bradrblack/device-monitor/hw/case/README.md

# Device Monitor cases

There are two printed cases. Both are a tray and a lid that click together with no
screws, and both clamp the accelerometer firmly so it feels the machine's vibration.

| | Slide-in case (recommended) | PCB case |
|---|---|---|
| Source | `slide_in_case.scad` | `device_monitor_case.scad` |
| Print | `slide_tray.stl`, `slide_lid.stl` | `tray.stl`, `lid.stl` |
| Outside | 46.2 x 27.6 x 15 mm | 55.8 x 31 x 23 mm |
| Electronics | SuperMini + GY-346, 4 wires soldered direct | SuperMini + GY-346 + bulk cap on the [carrier PCB](../PCB.md) |
| Parts held by | wall grooves, lid posts, floor rails and pins | printed pins through the PCB's holes, lid posts |
| RESET | flex tab in the lid | guide tube for a paperclip |
| Antenna | lid ceiling, in a recess | inside the lid's side skirt |
| Status LED | row of holes along the RESET side | through the vent holes |
| Zip-tie slot | 4.8 mm | 5.5 mm |

The slide-in case is smaller and needs no PCB order, only four short wires. Use the
PCB case if you already have carrier boards or want the bulk capacitor.

`check_case.sh [file.scad]` renders the clash checks for either case (lid against
tray, and each against the parts); every line must say ok after a change.

## Slide-in case

`slide_in_case.scad` builds a monitor without the carrier board: **46.2 x 27.6 x
15 mm** outside. The ESP32-C3 SuperMini and the GY-346 are joined by four wires
soldered straight to the pads, with no headers.

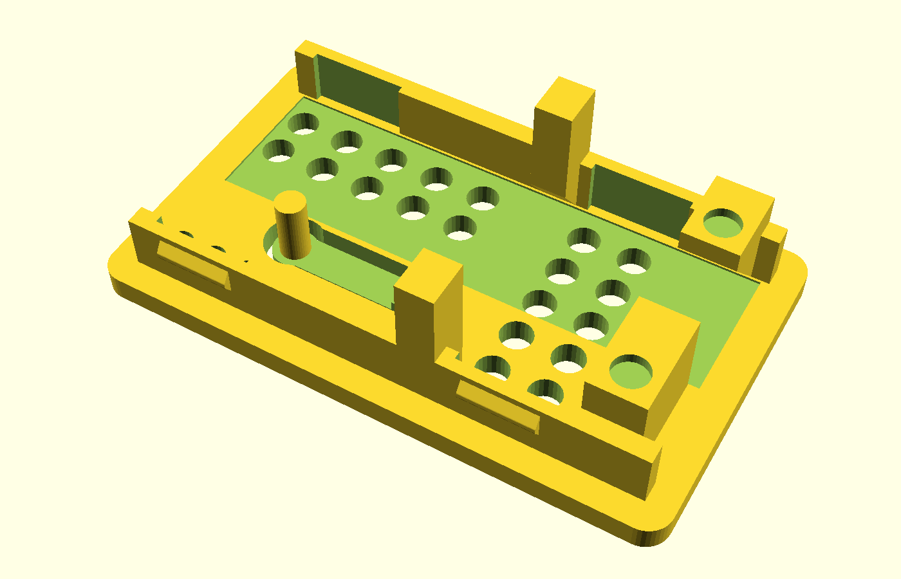
[picture p4: hw/case/slide-lid.png]
Slide-in lid from inside
Slide-in case, parts in the tray 
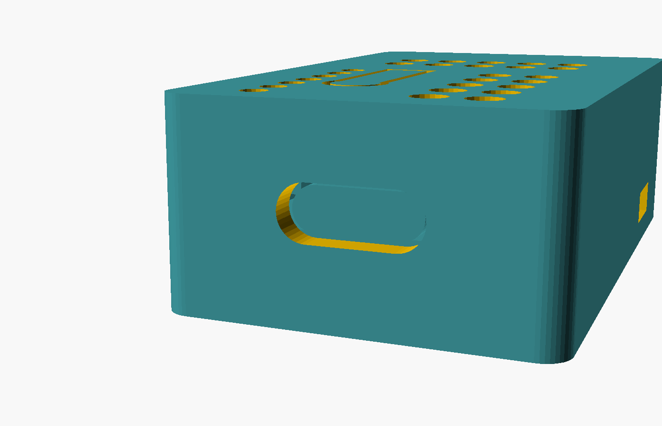
[picture p5: hw/case/slide-usb.png]
USB end
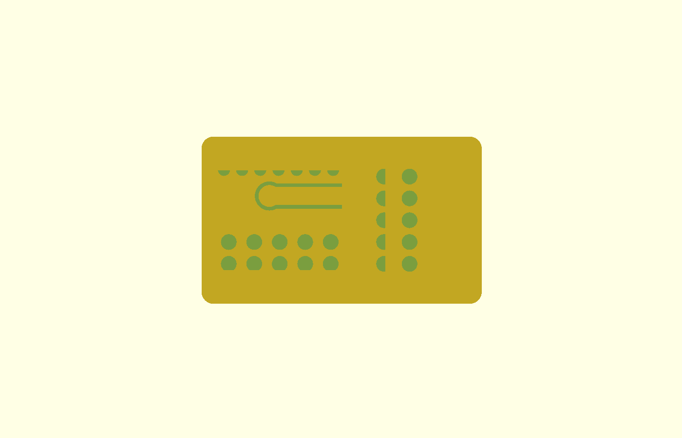
[picture p6: hw/case/slide-top.png]
Lid from above: reset tab, LED row, vents
 

| Wire | SuperMini pad | GY-346 pad |
|---|---|---|
| power | 3V3 | VIN |
| ground | GND | GND |
| SDA | 5 | SDA |
| SCL | 6 | SCL |

Leave CS and SDO open, as on the carrier with its jumpers open. About 35 mm of thin
wire each (26-30 AWG).

### How it holds the parts

- The SuperMini rides on two side ledges under its long edges. A lip over its edges
  toward the back stops it lifting, and its USB-C sits in a hole in the end wall.
  The lip stays clear of the front 9.5 mm, where the wires are soldered.
- Two posts on the lid drop in behind the SuperMini's rear corners. Pushing a cable
  in pushes the board back into them, and pulling a cable out pulls it forward
  against the end wall. The wires run back between the posts.
- The GY-346 sits on two floor rails with its header pads toward the SuperMini. Two
  pins come up through its mounting holes, and two lid feet press the board down
  around the holes. A firm clamp matters here, because a loose module reads its own
  rattle as vibration.
- The ribbon antenna sticks to the ceiling in a shallow recess down the lid's centre.
  The reset tab, the posts and the feet all stay out of that strip.
- **USB-C:** the end wall has a stadium-shaped hole 10 x 4 mm. The SuperMini slides
  forward until its USB-C receptacle sits in the hole, about 1 mm back from the outside
  face, so a cable plugs straight in.
- **RESET:** a flex tab is cut into the lid over the button (the keyhole shape), with a
  plunger under its round end. It sits over RESET as on the carrier: 9 mm from the USB
  end, on the far side when you look down with the USB-C pointing left. Press the tab to reset; a double press reopens the Wi-Fi
  portal. BOOT has no tab, since flashing over USB doesn't need it.
- The lid has a grid of 2.6 mm vent holes (one block over the SuperMini, one over the module), kept
  clear of the reset tab and the post and foot roots, plus a row of 2 mm holes along
  the SuperMini's RESET-side edge, over its LED. There is no label on the sides.
- The lid clicks on with the same skirts, wedges and divots as the PCB case. There is
  also a slot for a 4.8 mm zip tie under the module.

### Assembly

1. Solder the four wires, then test the module on the bench (first-boot steps in the
   main README).
2. Lower the SuperMini into the back half of the tray, USB-C forward, and set its front
   edge on the ledges just behind the lip. Its rear end rests on the module's two
   locating pins, so it tilts about 2 degrees. Slide it forward: it levels out under the
   lip, and the USB-C ends up in the end-wall hole.
3. Drop the GY-346 onto its two pins, components up.
4. Stick the antenna into the lid's recess, then press the lid down until it clicks.

### Measurements

The sizes come from measured parts (2026-11-14): SuperMini 22.5 x 18 x 1.0 mm bare
PCB, GY-346 holes 3.0 mm across, 15 mm apart, centres 2.5 mm from the edge opposite
the pins. The RESET position (`btn_from_front`, `btn_from_edge`) is the Sump Master 2000
measurement. Clones vary, so if yours differ, change the values at the top of
`slide_in_case.scad` and run `./check_case.sh slide_in_case.scad` (all three checks
must say ok) before re-exporting.

### Mounting

Same as the PCB case: VHB tape on a flat panel, or a zip tie (up to 4.8 x 2 mm)
through the slot under the module for a pipe. See [Mounting](#mounting) below.

### Printing

Print `slide_tray.stl` floor down and `slide_lid.stl` as exported (ceiling on the
bed): PLA or PETG, 0.2 mm layers, 3 walls, no supports. A light-coloured lid lets the
LED show through its row of holes. To re-export after a change:

```
./check_case.sh slide_in_case.scad      # each line must say ok
openscad --export-format binstl -o slide_tray.stl -D 'part="tray"' slide_in_case.scad
openscad --export-format binstl -o slide_lid.stl  -D 'part="lid"'  slide_in_case.scad
```

## PCB case

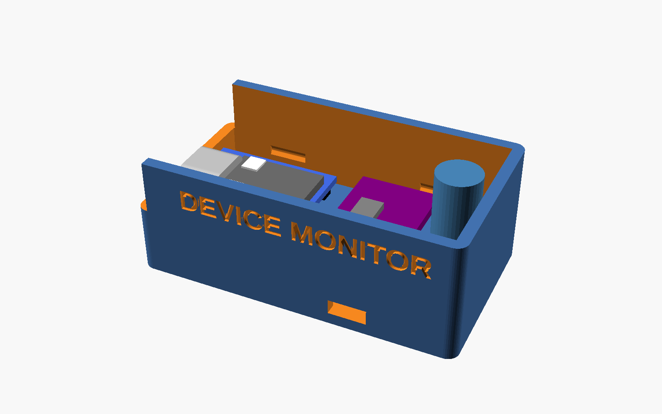
[picture p7: hw/case/case-fit.png]
Carrier in the tray
Closed case 

A two-part printed case (tray + lid) for the device monitor carrier PCB
(`../devmon_carrier.kicad_pcb`: ESP32-C3 SuperMini, GY-346 / ADXL346 module and one
bulk capacitor). Outside it is **55.8 x 31 x 23 mm**. The case is the same whether or not C1 is fitted
(the board works without it; it can be added later if needed).

| File | What it is |
|---|---|
| `device_monitor_case.scad` | The OpenSCAD source. Everything is a parameter at the top. |
| `tray.stl`, `lid.stl` | Ready to print. The lid is exported upside down (ceiling on the bed). |
| `check_case.sh` | Renders the clash checks: lid against tray, and each against the board and its parts. Run it after any change. |
| `case-*.png` | Renders: closed, carrier in the tray, the lid from inside, a section. |

It is built from the author's two earlier cases:

- From the **RF ceiling fan remote** case
  ([fan_dongle_case.scad](https://github.com/bradrblack/rf-ceiling-fan-remote/blob/main/hw/case/fan_dongle_case.scad)):
  no screws. Printed standoffs with pins go through the carrier's holes, and caps
  (hook posts) hang from the lid to clamp the board. A guide tube hangs over the
  RESET button for a paperclip. The USB and RESET positions are the same as on that
  case (same SuperMini footprint and position).
- From **Sump Master 2000**
  ([sump_case.scad](https://github.com/bradrblack/sump-master-2000/blob/main/hw/case/sump_case.scad)):
  the USB-C opening split between tray and lid (the tray's stub wall holds the lower
  half, the lid's end wall the upper half, so the board drops straight in), and the
  wedge-and-divot closure in place of a friction fit. The lid has two skirts that
  slide down inside the tray's walls. Each skirt is thinned to 1 mm at two pockets, and
  a rounded wedge on each pocket clicks into a divot in the tray wall. Closed,
  nothing is under load (0.1 mm clearance), so the fit doesn't creep loose.

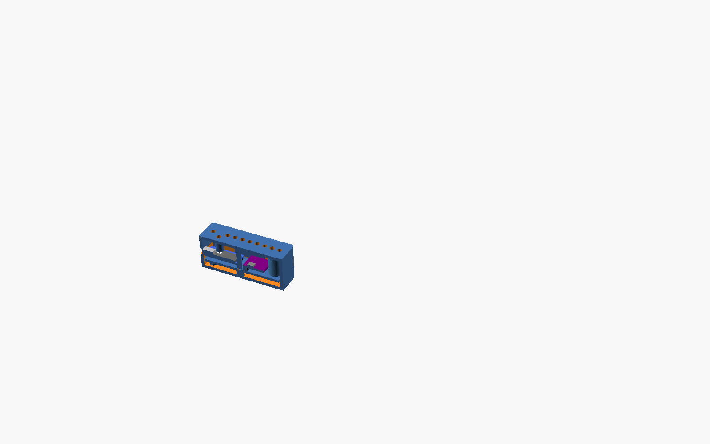
[picture p8: hw/case/case-section.png]
Section along the board


### How the board is held

| Hole (KiCad x, y) | Tray | Lid |
|---|---|---|
| H5 (3.75, 8), H6 (3.75, 16) | standoff + pin | nothing (the ESP module is above them); these take the USB plug's push |
| H1 (24.4, 12) | standoff + short pin, stopping inside the hole | solid 3.4 mm post pressing on the board around the hole (too tight between the ESP and J1 for a hollow cap) |
| H2 (45.3, 17.5) | standoff + pin | hollow 4.5 mm cap over the pin, 0.3 mm above the board |

The board sits on 3 mm standoffs, so its solder tails clear the floor. Once closed, the
H1 post and H2 cap hold the board down against its standoffs, so the accelerometer is
coupled to the case.

### Printing

- PLA or PETG, 0.2 mm layers, 3 walls, no supports.
- **Tray:** floor on the bed. **Lid:** as exported, ceiling on the bed, skirts and posts
  pointing up.
- Test the fit before using the case: the wedge (`detent`, 0.4 mm) and the pins
  (`pin_d`, 2.2 mm in 2.5 mm holes) are the values to adjust. If the lid clicks too
  hard, lower `detent` to 0.3. If it falls off, raise it to 0.5.
- A light-coloured lid lets the onboard status LED show through the vent holes.

### Assembly

1. Drop the carrier onto the tray's pins. Its USB-C connector settles into the lower half
   of the port in the tray's end wall.
2. Push the lid straight down until all four wedges click. Its end wall closes over the
   top of the connector.

To open it, pull the tray and lid apart firmly. The 35-degree wedge flanks let go
without tools.

**Reset:** push a paperclip or toothpick straight down through the hole near the USB end.
It lands on the SuperMini's RESET button (pressing it twice reopens the Wi-Fi setup
portal; see the main README).

### Antenna

The SuperMini v2's external ribbon antenna (about 40 x 11 mm) sticks flat to the inside of
the lid's skirt on the side away from the capacitor (the side with the label on the tray),
up against the ceiling. Stick it on before closing the case and route the cable to the
module's u.FL connector. The clash check includes it there.

### Mounting

The underside is flat, so it couples well to whatever it sits on. Use VHB tape on a
washer, dryer or AC cabinet. For a pipe, such as a sump pump discharge, thread one zip tie
(up to 5.5 x 2 mm) through the slot at floor level. It crosses the floor under the
carrier, where the board has no solder tails, and comes out the other side. Set
`strap = false` for a case without the slot.

### Changing it

The board numbers (`pcb_l`, `holes`, part positions and heights) are copied from
`../tools/gen_carrier.py`. If the board changes, update them and run:

```
./check_case.sh                    # each line must say ok
openscad --export-format binstl -o tray.stl -D 'part="tray"' device_monitor_case.scad
openscad --export-format binstl -o lid.stl  -D 'part="lid"'  device_monitor_case.scad
```

The cavity height follows the tallest part, the 12.5 mm capacitor (`cap_h`). `part="section"` and
`part="fit"` are useful previews.
