bradrblack/device-monitor/hw/case/case-lid.png

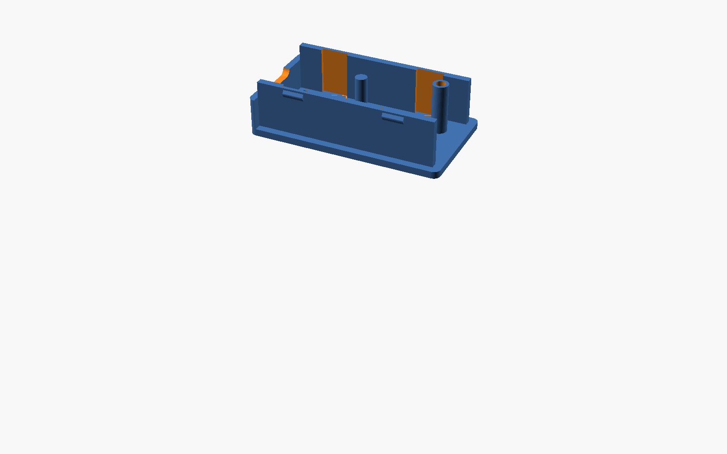
hw/case/case-lid.png
