bradrblack/device-monitor/hw/case/slide_lid.stl

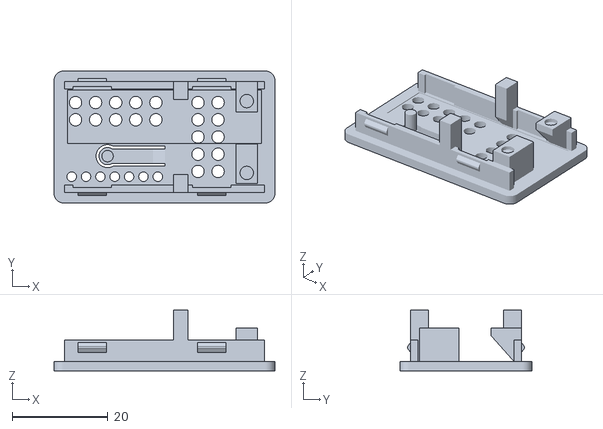
[picture p12: CAD file, 2026-11-14]
hw/case/slide_lid.stl
46.2 x 27.6 x 12.7
