bradrblack/device-monitor/hw/case/slide_tray.stl

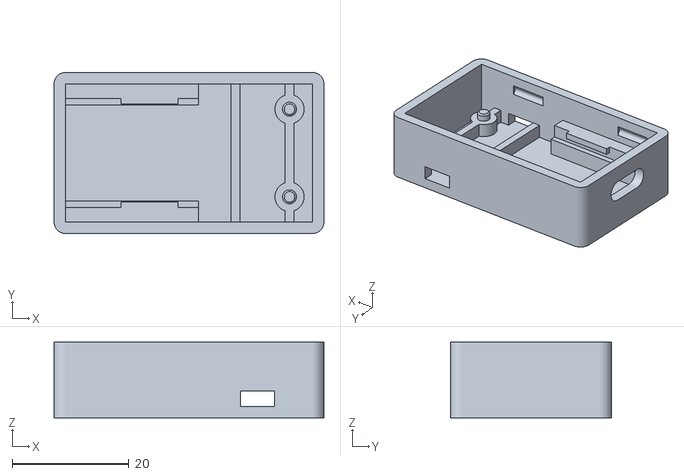
[picture p13: CAD file, 2026-11-14]
hw/case/slide_tray.stl
46.2 x 27.6 x 13.0
