bradrblack/device-monitor/hw/case/lid.stl

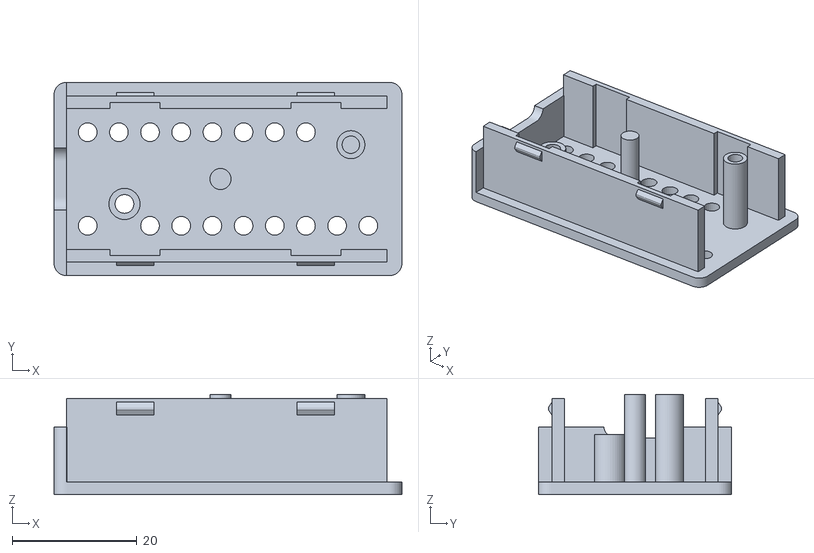
[picture p14: CAD file, 2026-11-13]
hw/case/lid.stl
55.8 x 31.0 x 16.1
