bradrblack/device-monitor/hw/case/tray.stl

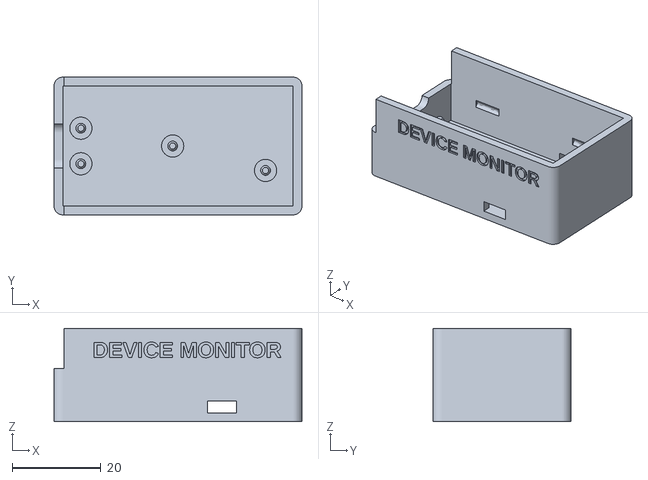
[picture p15: CAD file, 2026-11-13]
hw/case/tray.stl
55.8 x 31.0 x 21.0
