bradrblack/device-monitor/hw/devmon_carrier-schematic.pdf

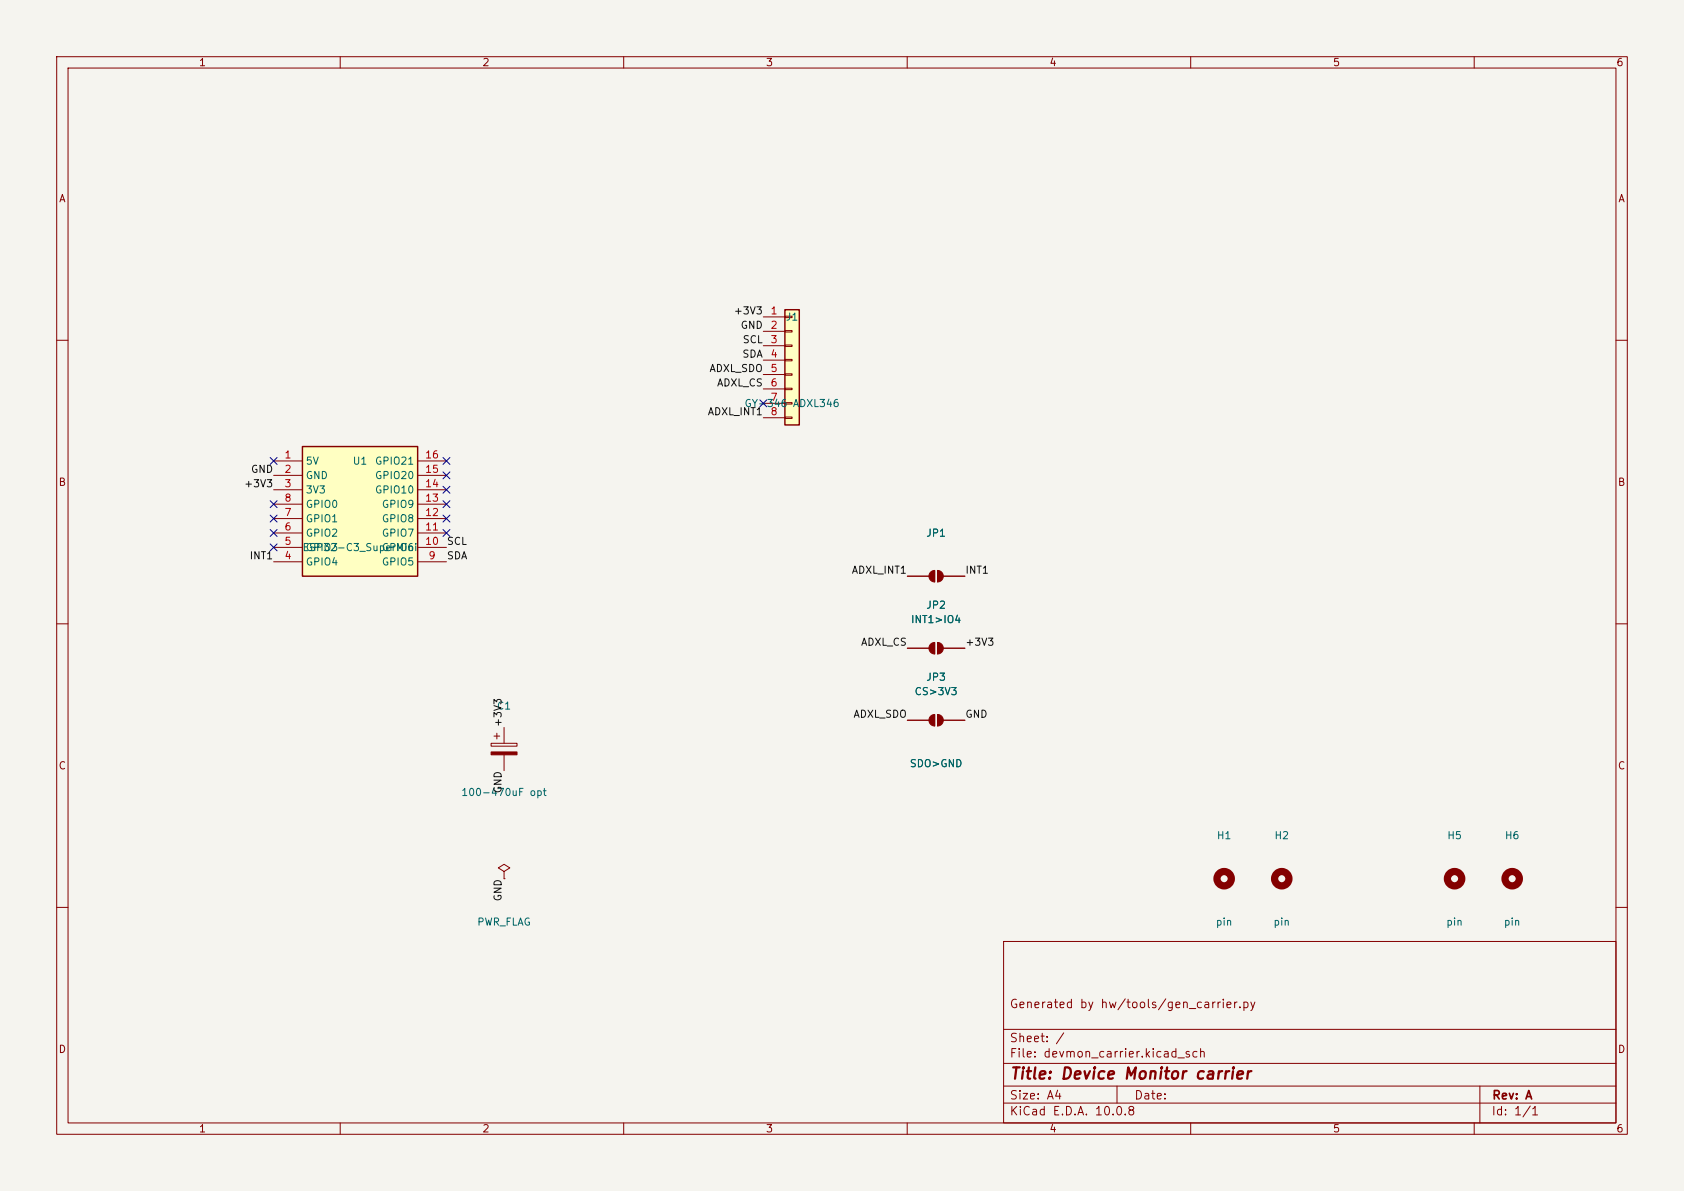
[picture p16: page 1]

Generated by hw/tools/gen_carrier.py

Sheet: /
File: devmon_carrier.kicad_sch
Title: Device Monitor carrier

Size: A4 | Rev: A
KiCad E.D.A. 10.0.8 | Id: 1/1
