bradrblack/device-monitor/hw/devmon_carrier.kicad_pcb

## KiCad design hw/devmon_carrier.kicad_pcb (2026-11-13)

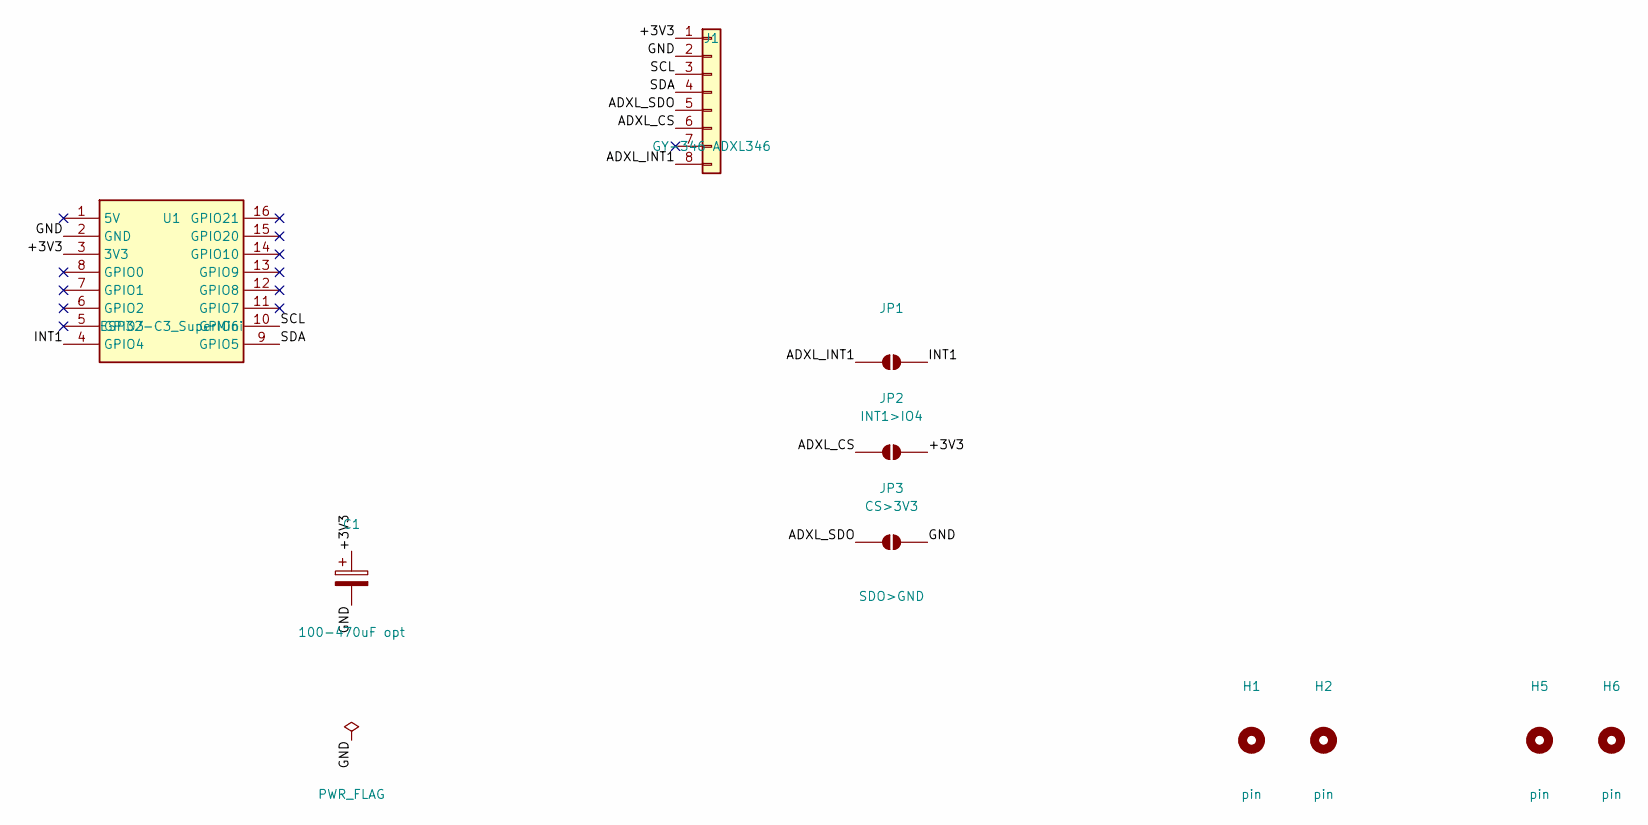
[picture p17: schematic devmon_carrier.kicad_sch, Device Monitor carrier]

Parts:
C1: 100-470uF opt; CP_Radial_D8.0mm_P2.50mm
H1, H2, H5, H6: pin; CasePin_Hole_2.5mm
J1: GY-346 ADXL346; PinHeader_1x08_P2.54mm_Vertical
JP1: INT1>IO4; SolderJumper-2_P1.3mm_Open_RoundedPad1.0x1.5mm
JP2: CS>3V3; SolderJumper-2_P1.3mm_Open_RoundedPad1.0x1.5mm
JP3: SDO>GND; SolderJumper-2_P1.3mm_Open_RoundedPad1.0x1.5mm
U1: ESP32-C3_SuperMini; ESP32-C3_SuperMini_FaceUp

Connections:
/+3V3: C1.1, J1.1, JP2.2 (B), U1.3 (3V3)
/ADXL_CS: J1.6, JP2.1 (A)
/ADXL_INT1: J1.8, JP1.1 (A)
/ADXL_SDO: J1.5, JP3.1 (A)
/GND: C1.2, J1.2, JP3.2 (B), U1.2 (GND)
/INT1: JP1.2 (B), U1.4 (GPIO4)
/SCL: J1.3, U1.10 (GPIO6)
/SDA: J1.4, U1.9 (GPIO5)

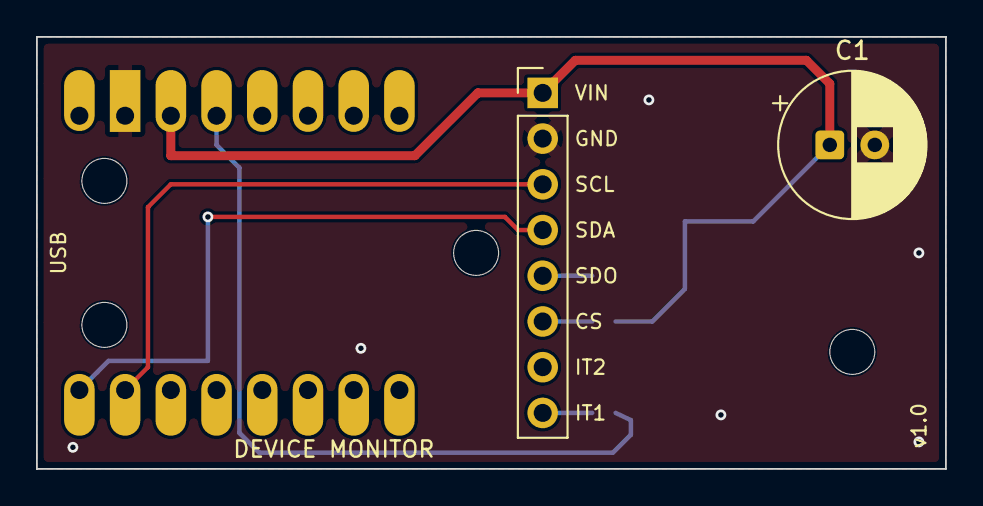
[picture p18: board devmon_carrier.kicad_pcb from above]

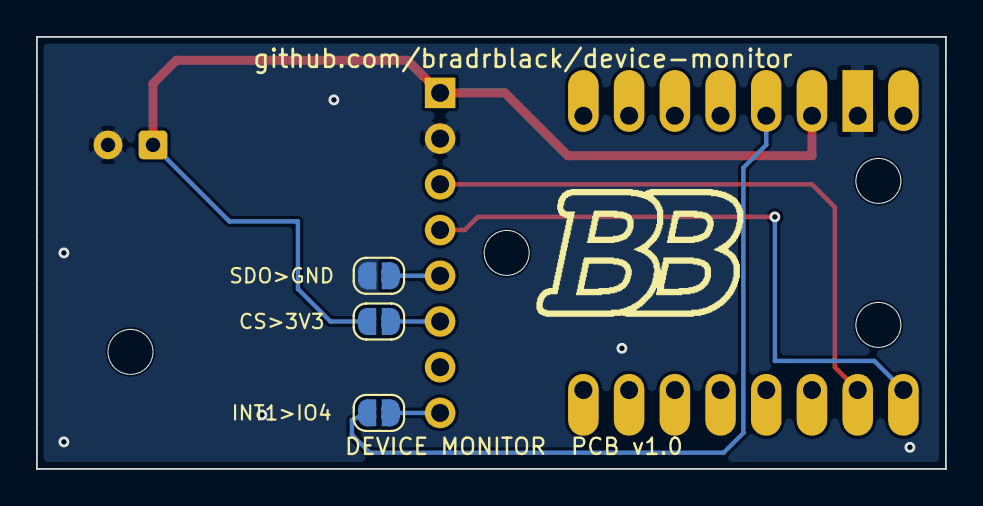
[picture p19: board devmon_carrier.kicad_pcb from below]

Board: 2 copper layers, 50.5 x 24.0 mm, 10 parts (3 on the bottom side), 8 nets.
