bradrblack/device-monitor/(commit log)

2026-11-13 Hardware: device-monitor carrier PCB v1.0 (cut-down sm2k carrier)
    Generated by hw/tools/gen_carrier.py: ESP32-C3 SuperMini + GY-346 (ADXL346)
    socket at the sm2k positions and pin mapping, one 100-470 uF bulk cap,
    bottom-side solder jumpers for ADXL INT1->GPIO4, CS->3V3, SDO->GND (open).
    47 x 24 mm, 2 layers, ERC and DRC clean with KiCad 10.0.8.
    Claude-Session: https://claude.ai/code/session_019Ex3Rgj5QYksKCtNgMXW92
    [devmon_carrier-B_Cu.gbl, devmon_carrier-B_Mask.gbs, devmon_carrier-B_Silkscreen.gbo, devmon_carrier-Edge_Cuts.gm1, devmon_carrier-F_Cu.gtl, devmon_carrier-F_Mask.gts, devmon_carrier-F_Silkscreen.gto, devmon_carrier-NPTH-drl_map.gbr]
2026-11-13 Docs: carrier PCB BOM, assembly and case dimensions (hw/PCB.md, README section)
    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
2026-11-13 Add printed case for the device monitor carrier
    OpenSCAD tray + lid for the 47 x 24 mm carrier (ESP32-C3 SuperMini,
    GY-346/ADXL346, bulk cap). Pins, lid caps, reset tube and USB-C through
    the lid's end wall follow the fan remote case; the wedge-and-divot
    closure follows sump-master-2000. check_case.sh renders the clash
    checks against the board and its parts. STLs and renders included.
    Claude-Session: https://claude.ai/code/session_019Ex3RfCqxNkESRr55taKZX
    [device_monitor_case.scad, lid.stl, tray.stl]
2026-11-13 Rebuild firmware on Sump Master 2000: setup portal, web UI, OTA, HA
    Ports the sm2k detection, calibration, reliability and reporting code,
    cut down to on/off. One image serves every unit: device name, Wi-Fi,
    thresholds and connections are set at run time (WiFiManager setup
    portal, then the web page at http://<name>.local/).
    - Guided calibration on the web page (measure idle / running, suggested
    thresholds)
    - ADXL345 / ADXL346 auto-detected by device ID
    - Optional InfluxDB (direct or Telegraf), ntfy, MQTT + HA discovery;
    Adafruit IO removed
    - ArduinoOTA and web upload with trial and rollback; mDNS
    - RESET pressed twice opens the setup portal
    - Telegraf listener config, extended Grafana d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
    [device-monitor.ino]
2026-11-13 Case: split the USB-C port between tray and lid; close the skirt gap
    The board now drops straight into the tray (sump-master-2000 style
    port), instead of being levered into a port wholly in the lid. H1
    becomes a solid lid post over a short tray pin, and the lid skirts
    run up to the end wall.
    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
    [device_monitor_case.scad, lid.stl, tray.stl]
2026-11-13 Carrier: regenerate with C1 value marked optional
    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
    [devmon_carrier-B_Cu.gbl, devmon_carrier-B_Mask.gbs, devmon_carrier-B_Silkscreen.gbo, devmon_carrier-Edge_Cuts.gm1, devmon_carrier-F_Cu.gtl, devmon_carrier-F_Mask.gts, devmon_carrier-F_Silkscreen.gto, devmon_carrier-NPTH-drl_map.gbr]
2026-11-13 Case: optional bulk cap (has_cap) with a 6 mm lower no-cap case
    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
    [device_monitor_case.scad, lid-nocap.stl, lid.stl, tray-nocap.stl, tray.stl]
2026-11-13 Case: one case for with/without C1; ledge for the ribbon antenna
    C1 is optional on the board but the case is always sized for it, so the
    no-cap STLs are gone. Adds a locating ledge on the inside of the y=0
    lid skirt for the SuperMini v2's 40 x 11 mm ribbon antenna, stopping
    short of the wedge pockets.
    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
    [device_monitor_case.scad, lid-nocap.stl, lid.stl, tray-nocap.stl, tray.stl]
2026-11-13 Case: drop the lid dimples, keep the vent holes
    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
    [device_monitor_case.scad, lid.stl]
2026-11-13 Case: remove the antenna ledge
    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
    [device_monitor_case.scad, lid.stl]
2026-11-13 Carrier + case: fit the 14 x 21 mm GY-346 module
    The measured GY-346 is 14 x 21 mm, not 9 x 20, so it reached x 40.83 and
    overlapped C1. C1 moves to (45.3, 6.0) and H2 to (45.3, 17.5); the board
    grows from 47 to 50.5 mm. ERC 0, DRC 0 (KiCad 10.0.8). The case follows
    (55.8 mm long outside); check_case.sh reports no clashes. Gerbers, BOM,
    renders, STLs and docs regenerated; README's duplicate Carrier PCB section
    and parts table removed.
    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
    [device_monitor_case.scad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]
2026-11-13 WiFi: reapply the TX power cap on every station/AP start; log the join failure reason
    WiFiManager restarts the Wi-Fi driver after setupWiFi() sets the 15 dBm cap,
    so older SuperMinis tried to join at full power and failed (Brad's board:
    AutoConnect FAILED for 30 s, portal reopens). Hook STA_START and AP_START to
    set the cap again, and log the last disconnect reason after autoConnect.
    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
    [device-monitor.ino]
2026-11-13 WiFi: print each failed join's reason and RSSI as it happens; banner starts on a fresh line
    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
    [device-monitor.ino]
2026-11-13 Web: log in once (GET /login + session cookie) instead of a 401 on each save
    Safari never showed the password box for the 401 Digest challenge on a form
    POST and sat waiting (saving Connections hung; Chrome and curl worked). Now
    GET /login does the Digest login and sets an HttpOnly, SameSite=Strict
    session cookie; POST handlers accept the cookie or a Digest header and answer
    an unauthenticated POST with a 'Log in first' page instead of a 401. The page
    shows a Log in link and sends any save to /login until logged in. Refused and
    failed logins are logged. A new admin password clears the sessions.
    Claude-Session: https://claude.ai/code/se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
    [device-monitor.ino]
2026-11-13 Calibration: fall back to the running average when running dips near idle
    The suggestion compared the quietest running moment with the loudest idle one,
    so a motor whose level dips now and then (Brad's microwave: idle avg 0.106,
    running avg 1.945) was always 'too close to idle'. Now it falls back to the
    running average (start 50%, stop 25% of the gap), then to the idle average.
    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
2026-11-14 Case: add a slide-in case for the SuperMini + GY-346 without the carrier PCB
    46.2 x 27 x 15 mm. SuperMini on side ledges with a rear lip, USB-C in the
    end wall, lid posts behind its rear corners; GY-346 on rails and pins
    through its mounting holes, clamped by lid feet; antenna recess in the
    ceiling. check_case.sh now takes the .scad file as an argument.
    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
    [slide_in_case.scad, slide_lid.stl, slide_tray.stl]
2026-11-14 Slide-in case: flex tab over RESET instead of a guide tube; explain the USB-C opening
    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
    [slide_in_case.scad, slide_lid.stl, slide_tray.stl]
2026-11-14 Slide-in case: vent grid on the lid, no side label; describe the drop-in
    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
    [slide_in_case.scad, slide_lid.stl, slide_tray.stl]
2026-11-14 Slide-in case: row of LED holes along the SuperMini's RESET-side edge
    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
    [slide_in_case.scad, slide_lid.stl]
2026-11-14 Slide-in case: mirror the layout so the reset tab is over RESET, not BOOT
    The carrier and PCB case put RESET at KiCad (9, 8), which is the far side
    looking down with USB-C to the left; the slide-in case had it mirrored.
    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
    [slide_in_case.scad, slide_lid.stl, slide_tray.stl]
2026-11-14 Slide-in case: vent holes in two tidy blocks, none half-blocked by the posts' corbels
    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
    [slide_in_case.scad, slide_lid.stl]
2026-11-14 Wi-Fi: never open the setup portal on its own once a network is saved
    After a router restart, a board that rebooted while the router was down
    sat in its open setup portal for 5 minutes at a time instead of rejoining.
    Now a board with a saved network skips the portal at boot, starts anyway
    and keeps retrying the saved network every 30 s. The portal still opens on
    a new board and on demand (double RESET or the web page).
    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
    [device-monitor.ino]
2026-11-14 Case: re-render the slide-in case images (vent grid, LED row, mirrored reset tab, no label)
    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
2026-11-14 Wi-Fi: join a saved network the way the original firmware did
    The original device-monitor firmware (station mode, TX power cap,
    WiFi.begin, modem sleep on) joined reliably for weeks on the same board
    and spot where the WiFiManager-based join keeps failing with AUTH_EXPIRE.
    Boards with a saved network now skip WiFiManager entirely and join that
    way; WiFiManager is only used for a new board or the portal on demand.
    Also drops WiFi.setSleep(false), which the original firmware never set.
    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
    [device-monitor.ino]
2026-11-14 Document both cases, with the slide-in case as the main build
    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
2026-11-14 Slide-in case: record the measured SuperMini and GY-346 sizes
    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
    [slide_in_case.scad]
2026-11-14 README: slide-in case render beside the Grafana screenshot, voice alerts note
    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
2026-11-14 Keep the board online while the setup portal is open; fix the slide-in RESET tab
    A double RESET (or two quick power bumps, which the C3 can't tell apart) on a
    board with a saved network now joins it first and runs the WiFiManager portal
    non-blocking beside normal operation. An unused portal closes after 5 minutes.
    The board's web page starts when the portal closes (both use port 80), and the
    Wi-Fi retry and watchdog stand down while it is open.
    Slide-in lid: the slot round the RESET tongue was a closed ring, so the tongue
    wasn't joined to the lid at its root and snapped off. The slot is now a U, open
    at the root; the tongue is 1.2 mm thick and its thinning ramps back to full
    thickness over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
    [slide_in_case.scad, slide_lid.stl]
